tristan-f-cool/LED-Cube/PCB/LEDCube-3x3x3/LEDCube-3x3x3-PCBA_BOM.txt

Partlist exported from T:/Eagle_/LEDCube-3x3x3/LEDCube-3x3x3.sch at 5/19/2026 6:13 PM

Part   Value          Device                          Package                  Description                          MF MPN OC_FARNELL OC_NEWARK POPULARITY PROD_ID     SF_SKU    VALUE
A1                    MA06-1                          MA06-1                   PIN HEADER                                  unknown    unknown   28                                    
C5     22pF           22PF-PTH-2.54MM-200V-5%         CAP-PTH-2.54             22pF ceramic capacitors                                                     CAP-09128             22pF 
C6     22pF           22PF-PTH-2.54MM-200V-5%         CAP-PTH-2.54             22pF ceramic capacitors                                                     CAP-09128             22pF 
C7                    CPOL-USE1.8-4                   E1,8-4                   POLARIZED CAPACITOR, American symbol                                                                   
C8                    CPOL-USE1.8-4                   E1,8-4                   POLARIZED CAPACITOR, American symbol                                                                   
CC1                   PINHD-1X1                       1X01                     PIN HEADER                                                       64                                    
CC2                   PINHD-1X1                       1X01                     PIN HEADER                                                       64                                    
CC3                   PINHD-1X1                       1X01                     PIN HEADER                                                       64                                    
CC4                   PINHD-1X1                       1X01                     PIN HEADER                                                       64                                    
CC5                   PINHD-1X1                       1X01                     PIN HEADER                                                       64                                    
CC6                   PINHD-1X1                       1X01                     PIN HEADER                                                       64                                    
CC7                   PINHD-1X1                       1X01                     PIN HEADER                                                       64                                    
CC8                   PINHD-1X1                       1X01                     PIN HEADER                                                       64                                    
CC9                   PINHD-1X1                       1X01                     PIN HEADER                                                       64                                    
D2     1N4004         1N4004                          DO41-10                  DIODE                                                                                                  
D3                    PINHD-1X5                       1X05                     PIN HEADER                                                       69                                    
DD1                   PINHD-1X4                       1X04                     PIN HEADER                                                       91                                    
DDD1                  PINHD-1X5                       1X05                     PIN HEADER                                                       69                                    
FT1                   PINHD-1X6                       1X06                     PIN HEADER                                                       79                                    
H1     STAND-OFFTIGHT STAND-OFFTIGHT                  STAND-OFF-TIGHT          Stand Off                                                                                              
H2     STAND-OFFTIGHT STAND-OFFTIGHT                  STAND-OFF-TIGHT          Stand Off                                                                                              
H3     STAND-OFFTIGHT STAND-OFFTIGHT                  STAND-OFF-TIGHT          Stand Off                                                                                              
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
R15    10K            R-US_R0805                      R0805                    RESISTOR, American symbol                                                                              
R16    220            R-US_R0805                      R0805                    RESISTOR, American symbol                                                                              
RESET1                MOMENTARY-SWITCH-SPST-PTH-6.0MM TACTILE_SWITCH_PTH_6.0MM Momentary Switch (Pushbutton) - SPST                                         SWCH-08441 COM-00097      
S1                    EG1218S                         EG1218                   SLIDING SWITCH                                                                                         
T1     2N3904         2N3904                          TO92                     NPN TRANSISTOR                                                   27                                    
T2     2N3904         2N3904                          TO92                     NPN TRANSISTOR                                                   27                                    
T3     2N3904         2N3904                          TO92                     NPN TRANSISTOR                                                   27                                    
U2     328P           ATMEGA328P_PDIP                 DIP28                    Atmel 328P                                                                  IC-09136              328P 
VIN1                  DCBARRELPTH                     DCJACK_2MM_PTH           2.0mm DC Barrel Jack             
LED    BLUE	      3mm diffused thru-hole
