tristan-f-cool/LED-Cube/(list of files, cad)

Other CAD files:
CAD/ledgrid4x4.stl
CAD/base.stl
