tristan-f-cool/LED-Cube/PCB/LEDCube-3x3x3/LEDCube-3x3x3.brd

## EAGLE design PCB/LEDCube-3x3x3/LEDCube-3x3x3.brd (2026-05-19)

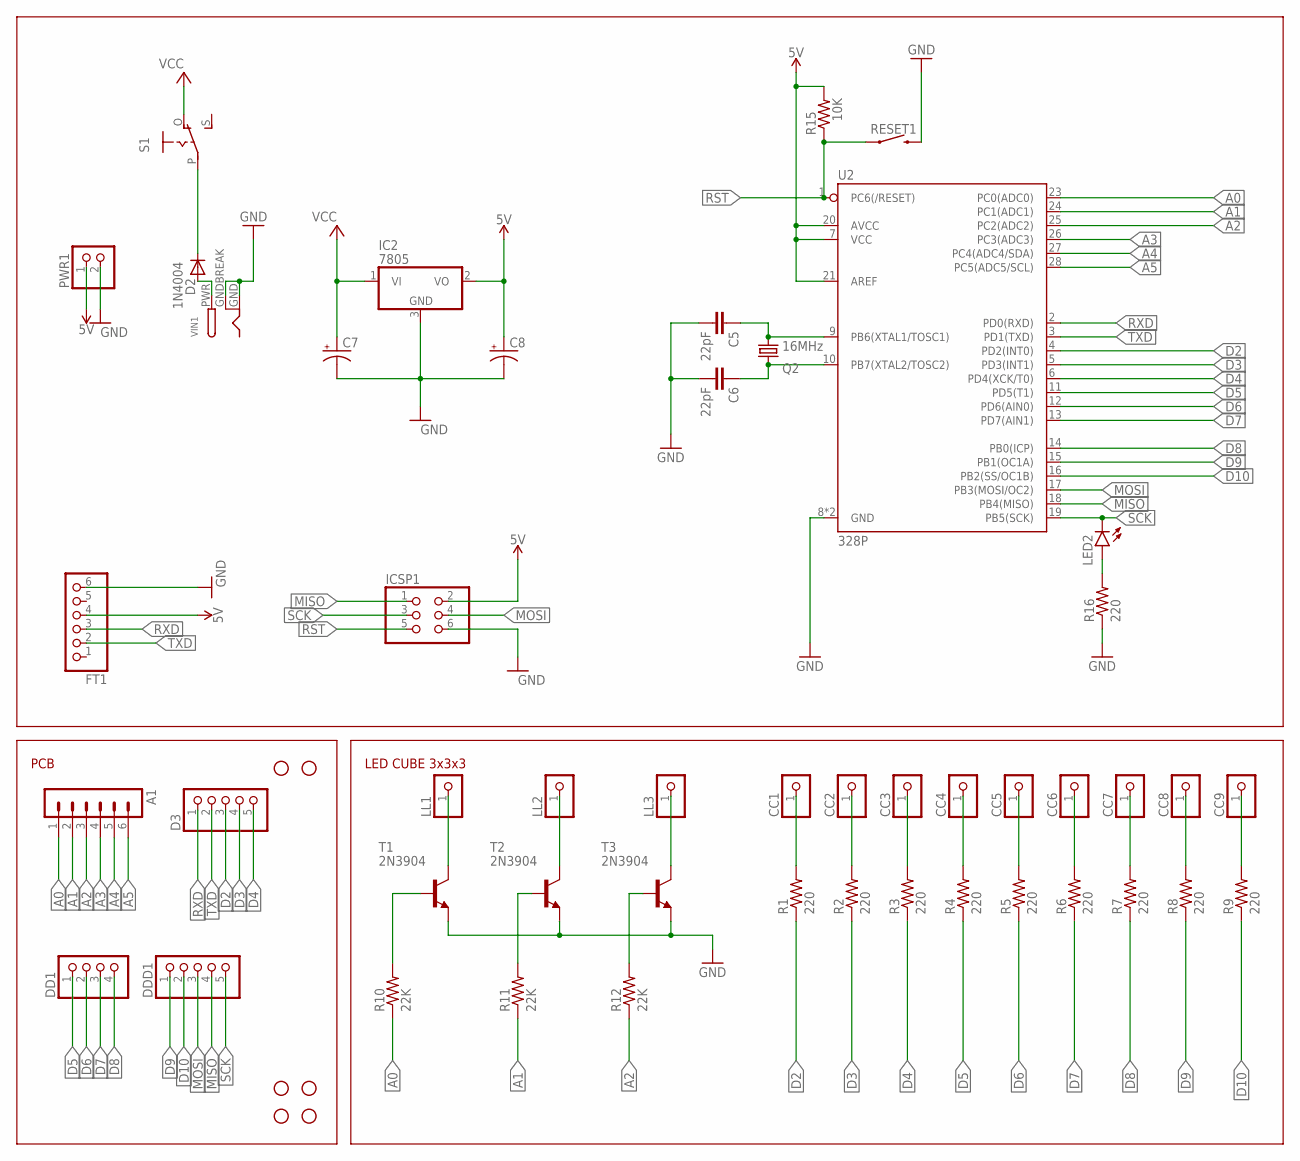
[picture p1: schematic LEDCube-3x3x3.sch]

Parts:
A1: MA06-1
C5, C6: 22pF; CAP-PTH-2.54
C7, C8: CPOL-USE1.8-4; E1,8-4
CC1, CC2, CC3, CC4, CC5, CC6, CC7, CC8, CC9: PINHD-1X1; 1X01
D2: 1N4004; DO41-10
D3: PINHD-1X5; 1X05
DD1: PINHD-1X4; 1X04
DDD1: PINHD-1X5; 1X05
FT1: PINHD-1X6; 1X06
H1, H2, H3, H4, H7, H8: STAND-OFFTIGHT; STAND-OFF-TIGHT
IC2: 7805; TO252
ICSP1: PINHD-2X3; 2X03
LED2: LEDCHIP-LED0805; CHIP-LED0805
LL1, LL2, LL3: PINHD-1X1; 1X01
PWR1: PINHD-1X2; 1X02
Q2: 16MHz; HC49/S
R1, R2, R3, R4, R5, R6, R7, R8, R9, R16: 220; R0805
R10, R11, R12: 22K; R0805
R15: 10K; R0805
RESET1: MOMENTARY-SWITCH-SPST-PTH-6.0MM; TACTILE_SWITCH_PTH_6.0MM
S1: EG1218S; EG1218
T1, T2, T3: 2N3904; TO92
U2: 328P; DIP28
VIN1: DCBARRELPTH; DCJACK_2MM_PTH

Connections:
5V: C8.+, FT1.4, IC2.2 (VO), ICSP1.2, PWR1.1, R15.2, U2.7 (VCC), U2.20 (AVCC), U2.21 (AREF)
A0: A1.1, R10.1, U2.23 (PC0(ADC0))
A1: A1.2, R11.1, U2.24 (PC1(ADC1))
A2: A1.3, R12.1, U2.25 (PC2(ADC2))
A3: A1.4, U2.26 (PC3(ADC3))
A4: A1.5, U2.27 (PC4(ADC4/SDA))
A5: A1.6, U2.28 (PC5(ADC5/SCL))
C3: CC3.1, R3.2
D2: D3.3, R1.1, U2.4 (PD2(INT0))
D3: D3.4, R2.1, U2.5 (PD3(INT1))
D4: D3.5, R3.1, U2.6 (PD4(XCK/T0))
D5: DD1.1, R4.1, U2.11 (PD5(T1))
D6: DD1.2, R5.1, U2.12 (PD6(AIN0))
D7: DD1.3, R6.1, U2.13 (PD7(AIN1))
D8: DD1.4, R7.1, U2.14 (PB0(ICP))
D9: DDD1.1, R8.1, U2.15 (PB1(OC1A))
D10: DDD1.2, R9.1, U2.16 (PB2(SS/OC1B))
GND: C5.2, C6.2, C7.-, C8.-, FT1.6, IC2.3 (GND), ICSP1.6, PWR1.2, R16.1, RESET1.3 (2), T1.3 (E), T2.3 (E), T3.3 (E), U2.8 (GND), U2.22 (GND), VIN1.GND, VIN1.GNDBREAK
MISO: DDD1.4, ICSP1.1, U2.18 (PB4(MISO))
MOSI: DDD1.3, ICSP1.4, U2.17 (PB3(MOSI/OC2))
unnamed: R10.2, T1.2 (B)
unnamed: R11.2, T2.2 (B)
unnamed: R12.2, T3.2 (B)
unnamed: LL1.1, T1.1 (C)
unnamed: D2.C, S1.P
unnamed: LL2.1, T2.1 (C)
unnamed: LL3.1, T3.1 (C)
unnamed: CC1.1, R1.2
unnamed: CC2.1, R2.2
unnamed: CC4.1, R4.2
unnamed: CC5.1, R5.2
unnamed: CC6.1, R6.2
unnamed: CC7.1, R7.2
unnamed: CC8.1, R8.2
unnamed: CC9.1, R9.2
unnamed: C5.1, Q2.1, U2.9 (PB6(XTAL1/TOSC1))
unnamed: C6.1, Q2.2, U2.10 (PB7(XTAL2/TOSC2))
unnamed: LED2.A, R16.2
unnamed: D2.A, VIN1.PWR
RST: ICSP1.5, R15.1, RESET1.1, U2.1 (PC6(/RESET))
RXD: D3.1, FT1.3, U2.2 (PD0(RXD))
SCK: DDD1.5, ICSP1.3, LED2.C, U2.19 (PB5(SCK))
TXD: D3.2, FT1.2, U2.3 (PD1(TXD))
VCC: C7.+, IC2.1 (VI), S1.O

Notes on the sheet:
PCB
LED CUBE 3x3x3

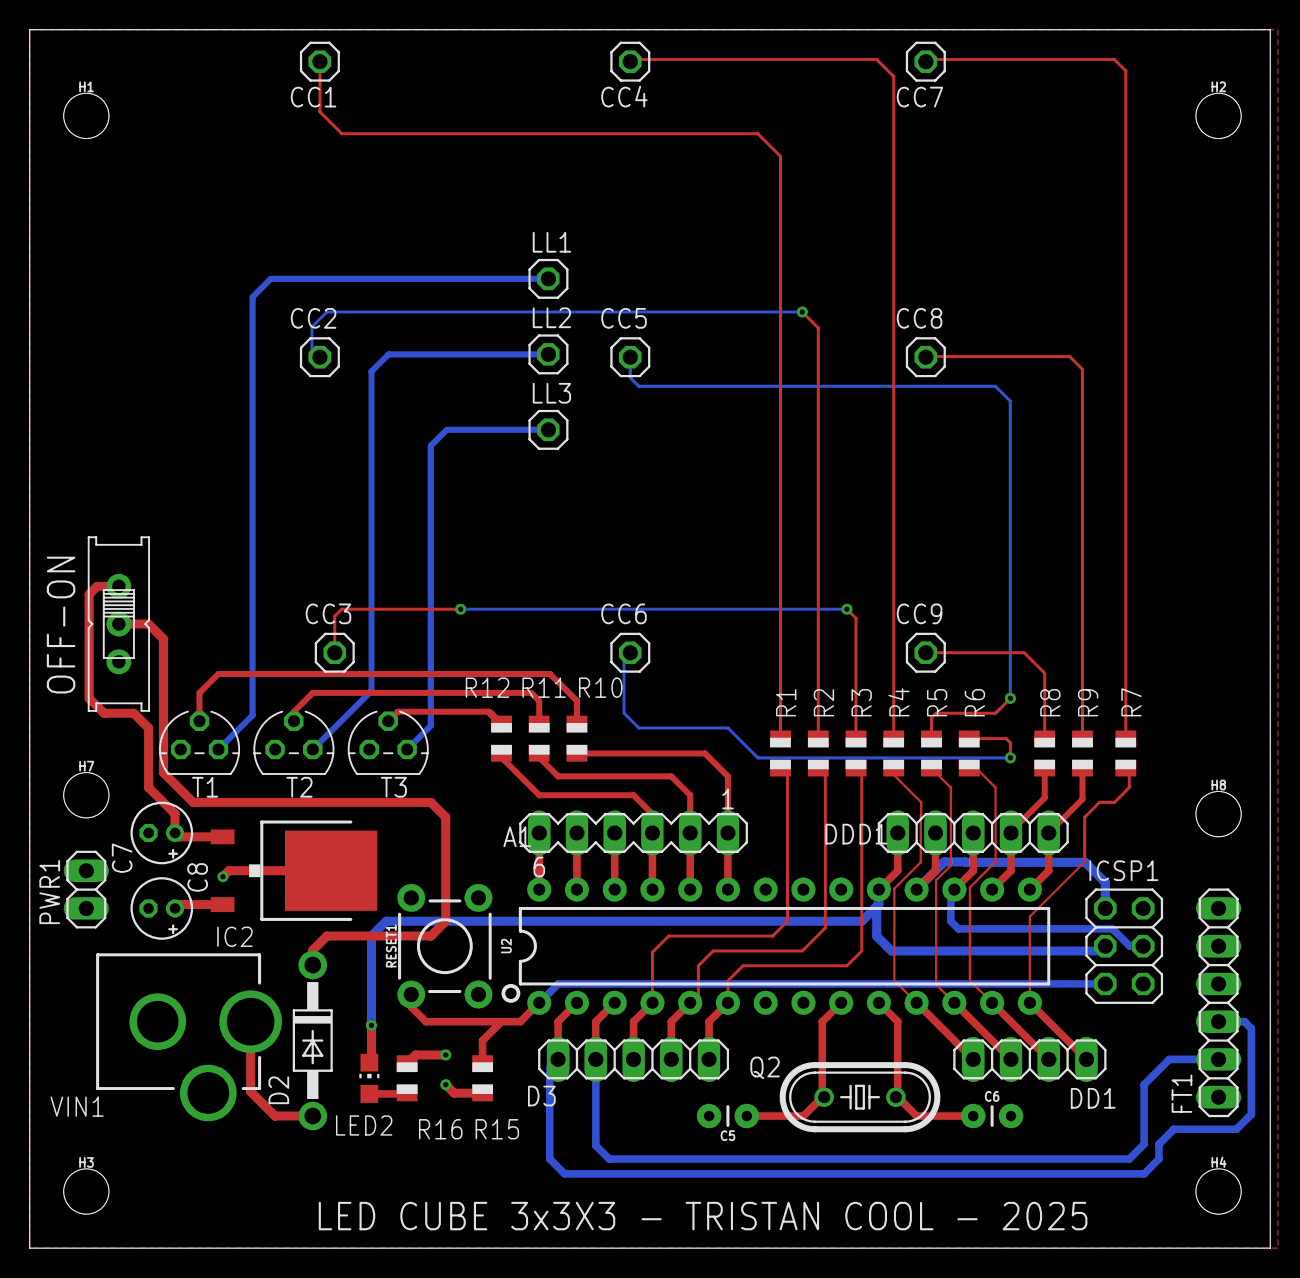
[picture p2: board LEDCube-3x3x3.brd from above]

Board: 2 copper layers, 83.5 x 82.0 mm, 54 parts (0 on the bottom side), 44 nets.
