tristan-f-cool/LED-Cube/(commit log)

2026-05-19 Eagle PCB schematic, layout and gerber manufacturing files
    [LEDCube-3x3x3.brd, LEDCube-3x3x3.sch]
2026-05-19 Arduino (Atmega 328P) application firmware
2026-10-28 CAD for 3D printer support and base.
    [base.stl, ledgrid4x4.stl]
